nroohh/ERAV2/documentation.docx

# ERA

Date: November 23, 2025

Written by: Siwoo Kim

# Introduction

ERA, originally an acronym for Ephemeral Rocket Agency, started on June 24th, 2024, as a CAS project by Siwoo Kim and Jaeung Kim with the objective of creating a chemical model rocket capable of controlled flight using thrust vector control (TVC) technology. It was planned to be about a 6-month project, a relatively short amount of time for an engineering project (hence the first word in its original name). However, due to its unforeseen complexity the project has extended to beyond what I’d call ephemeral, lasting to this day.

Due to school restrictions on chemical explosives, the original goal had to be somewhat discarded, and a spinoff had to be made. The project took a sharp turn to using the thrust from a battery powered electric ducted fan (EDF) as means of propulsion, while keeping the former intent of using TVC. Given the circumstances, I think a more suitable acronym for this project would be Electric Rocket Agency.

This documentation is intended to be used as a guide for future attempts at similar projects, to serve as a manual for the technologies used in the making of the project’s “rocket” or rather a monocopter, and something to go against time that fades memories and knowledge I acquired in the process.

# Hardware

## Tools & Manufacturers

All designs were first modeled in a Computer Aided Design (CAD) software and an Electronic Design Automation (EDA) to prevent causing errors down the line. Fusion 360 was used to model various components of the drone, and KiCAD for designing and routing the Printed Circuit Board (PCB). Designed parts were manufactured mostly within the boundaries of Chung Nam Samsung Academy (CNSA), using its Bambu Lab 3D printers. PCB design files were handed over to manufacturers at PCBWay and was manufactured and shipped.

### Fusion 360

Fusion 360 is a subscription based CAD platform that allows creators to model and assemble 3D components. However, it offers free plans for students at various academic grounds including CNSA. After validating oneself as a student, Fusion 360 student license can be activated for free!

### Bambu Lab

CNSA has its collection of Bambu Lab P1S printers in the Arts & Tech Lab. By asking nicely, one can manage to use one of these printers for free. Bambu Lab P1S printers almost guarantees high precision 3D prints with automatic bed leveling! 3D models designed in Fusion 360 can be printed in one of these 3D printers using a slicer software called BambuStudio

### KiCAD

KiCAD is a opensource software, or rather a bundle of softwares that significantly eases the PCB designing process. It allows anyone with appropriate knowledge to make a circuit schematic, and design a custom PCB for use. Gerber files from the design can be exported and sent to any PCB manufacturers for production.

### PCB Way

PCB Way is a PCB manufacturer. It provides two options in the manufacturing process. The first option is to produce only the PCB itself, and the second to produce the PCB and assemble the parts. Choosing the first option has the benefit of low costs and rapid manufacturing and delivery (about a week). However, electronic components have to be bought and soldered onto the produced PCB board separately. The second option of choosing the full assembly has the benefit of getting shippped a fully functioning PCB without the need to solder needed components separately. In choosing this option a Bill of Materials(BoM) file has to be sent together with the PCB gerber files for PCB Way to source electric components themselves and evaluate the production costs. Manufacturing and assembling the PCB may take as long as a month, with occasional confirmations from the PCB Way to confirm its production.

## Electronics

One way of achieveing stable flight with TVC is by using of an appropriate flight controller. By purchasing an appropriate flight controller and hooking it up to servos and needed sensors would probably result in a stable TVC flight using a prebuilt software. However, to comply with purpose of this project of understanding the mechanisms of TVC and using it, a basic microcontroller was selected to serve the role of a flight controller, and various sensors used to determine the position and angular displacements.

### Microcontroller

A microcontroller is a small programmable device with a chip that is used for reading input from various sensors and sending output to control actuators. A microcontroller widely used in hobby electronics is the Arduino Uno. Despite its wide use in simple prototyping projects, it has its limits on processing power and wireless communication which is needed for transmitting commands from the computer to the drone. An alternative promptly available was the DOIT ESP32 Devkit V1 microcontroller. The microcontroller had both Wi-Fi and Bluetooth capabilities with better processing power. Thus it was selected as the microcontroller to control the whole drone.

### Inertial Mearsurement Unit

Inertial Measurement Unit (IMU) is a group of sensors that senses orientation. MPU9250 9-axis sensor was selected to determine the x, y, z components of acceleration, angular acceleration, and magnetic fields, allowing the angular orientation to be determined accurately.

### Time of Flight Sensor

A Time of Flight (ToF) sensor is a sensor that determines the distance from the object that the sensor is pointed at by emitting a LASER and measuring the time it takes to reflect come back to the sensor. This sensor is used in the drone for determining its current height above the ground. The reading will allow the drone to maintain its height above ground by providing it a feedback loop that can be adjusted autonomously.

### Electric Ducted Fan

An EDF of following specifications were selected to be used as the main source of thrust.

Parameter | Value
Diameter | 64mm
Number of blades | 12
Voltage | 6S 22.2V
Current | 40A
KV-rating | 2840-2300KV
Maximum thrust | 1650g

### Electric Speed Controller

To use an EDF, an appropriate ESC has to be selected. Hobbywing XRotor 40A ESC was selected as it matched the requirements of the EDF. At the time of selection existence of Battery Eliminator Circuit (BEC) output was neglected, leading to choosing an ESC without the support of BEC. This resulted in the microcontroller having to be powered by an additional set of batteries. It is advised to check the BEC availbility before selecting an ESC for a project.

Parameter | Value
Model | XRotor 40A
Input | 2-6S LiPo
Continuous Current | 40A
Instantaneous Current | 60A (10 seconds)
Size | 68x25x8.7mm
Weight | 26g
BEC Output | None

### Battery

An HRB Lipo battery of following specifications were used.

Parameter | Value
Type | Lipo
Cells | 6S
Voltage | 22.2V
Discharge rate | 35C
Capacity | 2600 mah
Size | 115x34x51mm
Weight | 364g
Plug type | XT60

## Design

…

## Components

…

## Assembly

…

# Software

## Tools & Libraries

## Structure

## BLE communication

### Client

### Server

## Control Loop

## PID

## Sensor Calibration
