nroohh/ERAV2/p2.3mf

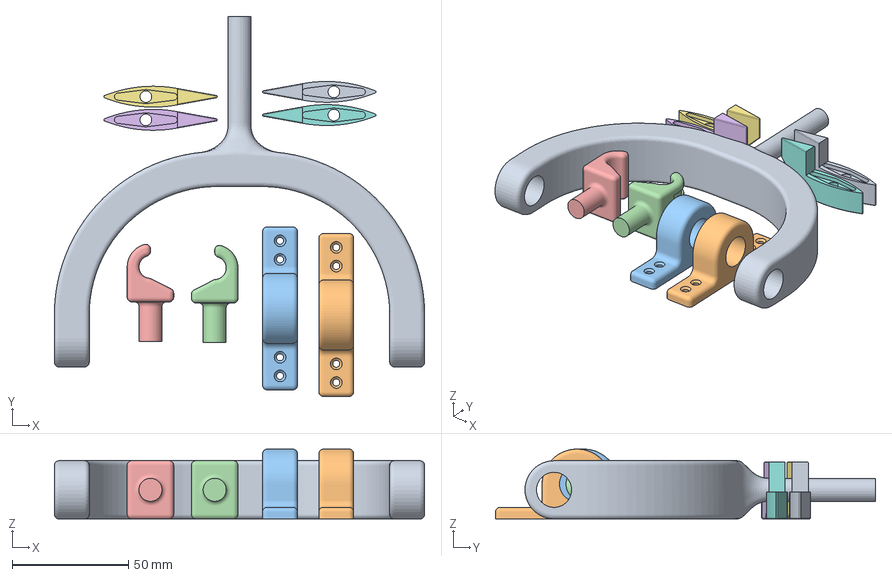
[picture p1: CAD file, 2025-12-02]
p2.3mf
159.0 x 163.1 x 30.0 mm
Body1.stl
Body7.stl x 2
Body8.stl
Body9.stl
Body3.stl x 4
