nroohh/ERAV2/PCB/KICAD/PCB.stl

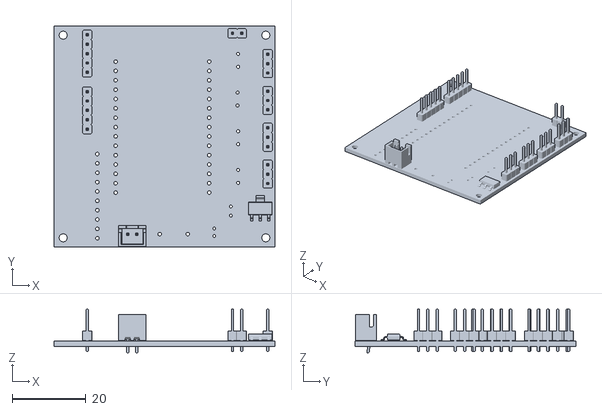
[picture p2: CAD file, 2025-12-30]
PCB/KICAD/PCB.stl
60.0 x 60.0 x 11.9
