nroohh/ERAV2/p1.3mf

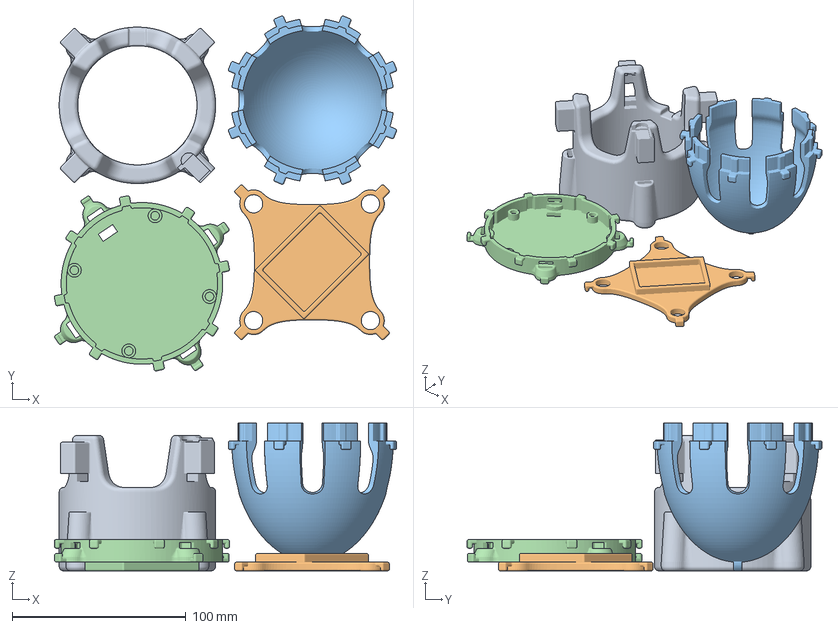
[picture p3: CAD file, 2025-12-02]
p1.3mf
196.9 x 204.2 x 85.0 mm
Body1.stl x 3
Body16.stl
