nroohh/ERAV2/(list of files, drawings)

Other design files:
PCB/KICAD/freerouting.dsn
PCB/KICAD/temp-freerouting.dsn
