nroohh/ERAV2/PCB/KICAD/PCB.kicad_pcb

## KiCad design PCB/KICAD/PCB.kicad_pcb (2025-12-30)

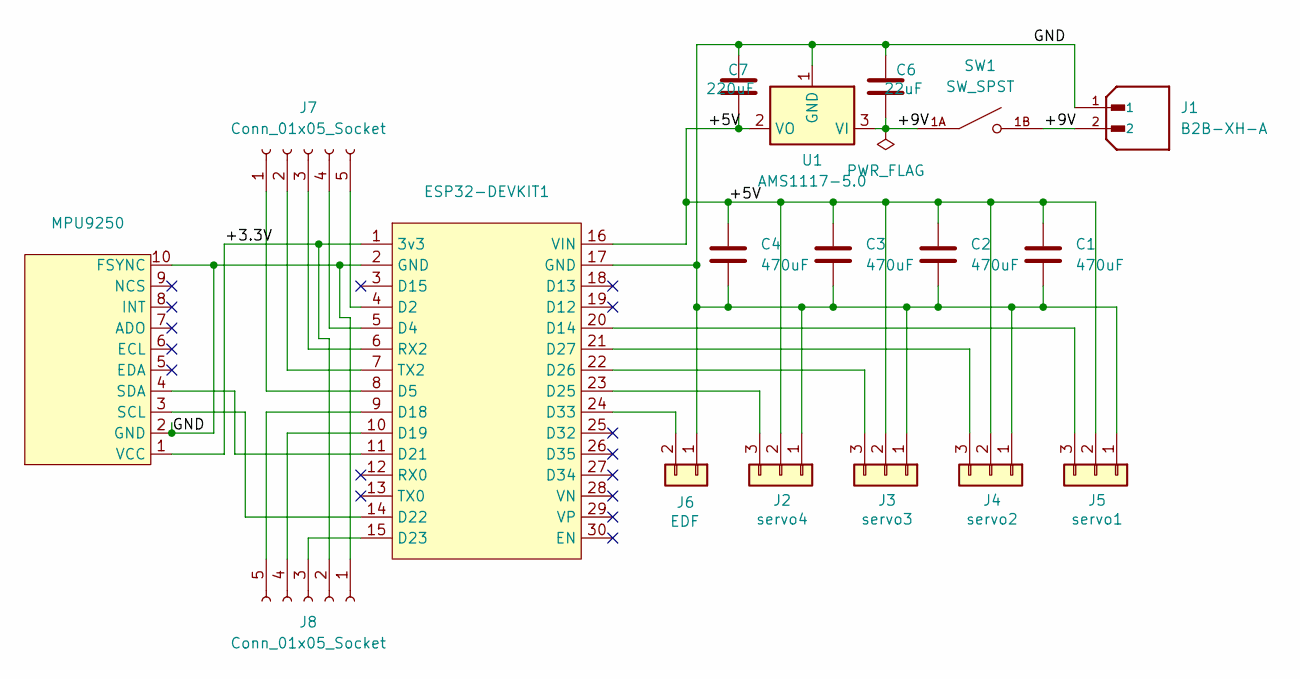
[picture p4: schematic PCB.kicad_sch]

Parts:
C1, C2, C3, C4: 470uF; CAP_YX_8X11P5_RUB
C6: 22uF; CAP_PAN_5X11_PAN
C7: 220uF; CAP_PAN_6.3X11.2_PAN
ESP32-DEVKIT1: ESP32 DEVKIT V1
J1: B2B-XH-A; JST_XH_B2B-XH-A_1x02_P2.50mm_Vertical; PARTREV N/A
J2: servo4; PinHeader_1x03_P2.54mm_Vertical
J3: servo3; PinHeader_1x03_P2.54mm_Vertical
J4: servo2; PinHeader_1x03_P2.54mm_Vertical
J5: servo1; PinHeader_1x03_P2.54mm_Vertical
J6: EDF; PinHeader_1x02_P2.54mm_Vertical
J7, J8: Conn_01x05_Socket; PinHeader_1x05_P2.54mm_Vertical
MPU9250: MPU9250
SW1: SW_SPST; SW_DS01-254-L-01BE; PARTREV 1.0
U1: AMS1117-5.0; SOT-223-3_TabPin2

Connections:
/+3.3V: ESP32-DEVKIT1.1 (3v3), J8.2, MPU9250.1 (VCC)
/+5V: C1.1, C2.1, C3.1, C4.1, C7.1, ESP32-DEVKIT1.16 (VIN), J2.2, J3.2, J4.2, J5.2, U1.2 (VO)
/+9V: C6.1, J1.2, SW1.1A, SW1.1B, U1.3 (VI)
/GND: C1.2, C2.2, C3.2, C4.2, C6.2, C7.2, ESP32-DEVKIT1.2 (GND), ESP32-DEVKIT1.17 (GND), J1.1, J2.1, J3.1, J4.1, J5.1, J6.1, J8.1, MPU9250.2 (GND), MPU9250.10 (FSYNC), U1.1 (GND)
unnamed: ESP32-DEVKIT1.4 (D2), J7.5
unnamed: ESP32-DEVKIT1.5 (D4), J7.4
unnamed: ESP32-DEVKIT1.8 (D5), J7.1
unnamed: ESP32-DEVKIT1.20 (D14), J5.3
unnamed: ESP32-DEVKIT1.9 (D18), J8.5
unnamed: ESP32-DEVKIT1.10 (D19), J8.4
unnamed: ESP32-DEVKIT1.11 (D21), MPU9250.4 (SDA)
unnamed: ESP32-DEVKIT1.14 (D22), MPU9250.3 (SCL)
unnamed: ESP32-DEVKIT1.15 (D23), J8.3
unnamed: ESP32-DEVKIT1.23 (D25), J2.3
unnamed: ESP32-DEVKIT1.22 (D26), J3.3
unnamed: ESP32-DEVKIT1.21 (D27), J4.3
unnamed: ESP32-DEVKIT1.24 (D33), J6.2
unnamed: ESP32-DEVKIT1.6 (RX2), J7.3
unnamed: ESP32-DEVKIT1.7 (TX2), J7.2

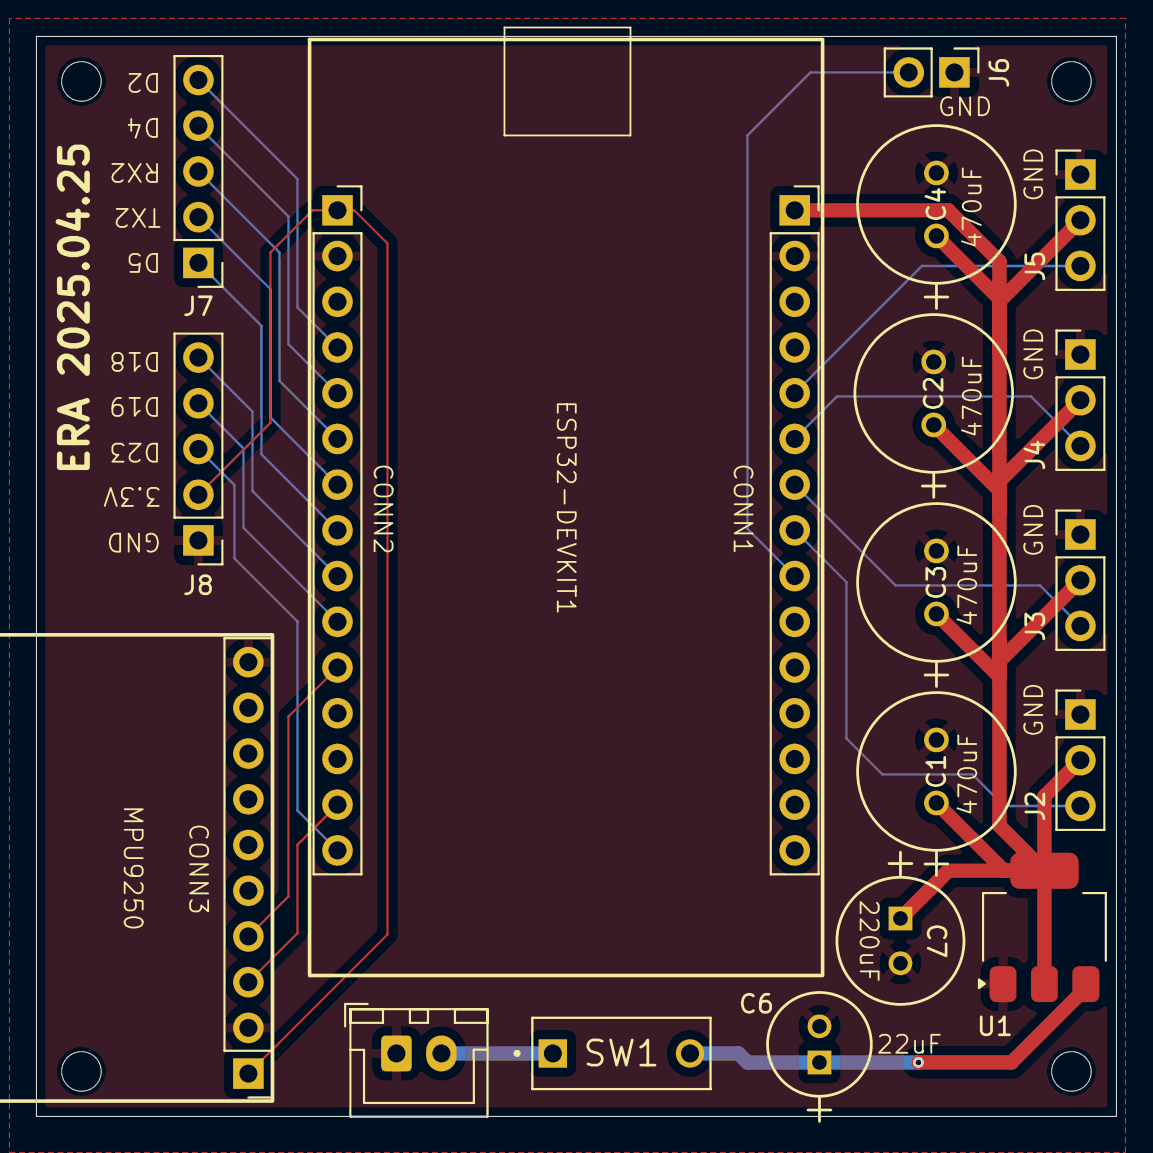
[picture p5: board PCB.kicad_pcb from above]

Board: 2 copper layers, 60.0 x 60.0 mm, 18 parts (0 on the bottom side), 19 nets.
